TheRARELab/fog-screen-robot-system/README.md

# Anywhere Projected AR for Robot Communication: A Mid-Air Fog Screen-Robot System

This repo has CAD files and code for the following HRI 2025 paper:

> Adrian Lozada, Uthman Tijani, Villa Keth, Hong Wang and Zhao Han.
> "Anywhere Projected AR for Robot Communication: A Mid-Air Fog Screen-Robot System".
> 2025 ACM/IEEE International Conference on Human-Robot Interaction (HRI), 2025.

### Useful links:

- Paper webpage: https://therarelab.com/publications/hri25-anywhere-projected-ar-for-robot-communication-a-mid-air-fog-screen-robot-system/
- Videos are available at https://osf.io/b4efu/.
