TheRARELab/fog-screen-robot-system/fog-machine-control/PCB/README.md

# Fog Machine Controller PCB

This folder holds the PCB design files.

- **BOM_2024-11-13.csv**
  Bill of Materials listing all required components.
- **Gerber_PCB_2024-11-13.zip**
  Gerber manufacturing files for PCB fabrication.
- **PickAndPlace_PCB_2024-11-13.csv**
  Automated assembly coordinates for each component.
