TheRARELab/fog-screen-robot-system/cad_models/iteration_1/README.md

Please see [assembly.md](assembly.md) and [parts.csv](parts.csv).
