TheRARELab/fog-screen-robot-system/fog-machine-control/PCB/PCB-Materials/BOM_2024-11-13.csv

ID | Name | Designator | Footprint | Quantity | Manufacturer Part | Manufacturer | Supplier | Supplier Part | Price | Pins | 3DModel | Contributor | JLCPCB Part Class | link
1 | SS34_C466502 | D1,D2 | SMA_L4.4-W2.6-LS5.0-RD | 2 | SS34 | High Diode(海德) | LCSC | C466502 | 0.056 | 2 | SMA_L4.4-W2.6-LS5.0-RD | LCSC | Extended Part | https://item.szlcsc.com/301402.html
2 | HFD2/005-M-L2 | K1 | RELAY-TH_HFD2-X-X-L2-X | 1 | HFD2/005-M-L2 | HF(宏发) | LCSC | C399485 | 2.147 | 10 | RELAY-TH_HFD2-X-X-L2-X | LCSC | Extended Part | https://item.szlcsc.com/382300.html
3 | WJ500V-5.08-3P-14-00A | P1 | CONN-TH_3P-P5.00_WJ500V-5.08-3P | 1 | WJ500V-5.08-3P | KANGNEX(康奈克斯电气) | LCSC | C72334 | 0.157 | 3 | CONN-TH_3P-P5.00_WJ500V-5.08-3P | 立创EDA官方封装库 | Extended Part | https://item.szlcsc.com/73443.html
4 | 2N4401_C15986 | Q1,Q2 | TO-92-3_L4.9-W3.7-P1.27-L | 2 | 2N4401 | CJ(江苏长电/长晶) | LCSC | C15986 | 0.028 | 3 | TO-92-3_L4.9-W3.7-P1.27-L | lcsc | Extended Part | https://atta.szlcsc.com/upload/public/pdf/source/20180629/C233232_99576441F8ED8E9074FB1575A6BE3592.PDF
5 | 1kΩ | R1,R2 | R0402 | 2 | RC0402FR-071KL | YAGEO(国巨) | LCSC | C106235 | 0.001 | 2 | R0402_L1.0-W0.5-H0.5 | lcsc | Extended Part | https://item.szlcsc.com/323315.html
6 | PM2.54-YP1D-15A | U1,U2 | HDR-TH_15P-P2.54-V-F | 2 | PM2.54-YP1D-15A | XYECONN(辛译) | LCSC | C22399555 | 0.2 | 15 | HDR-TH_15P-P2.54-V-F | lcsc | Extended Part | https://lcsc.com/product-detail/Pin-Header-Female-Header_Made-in-China-Made-in-China-Headers-Pins-1-15P-2-54mm_C54102.html
7 | HLK-PM01 | U3 | PWRM-TH_HLK-PM01 | 1 | HLK-PM01 | HI-LINK(海凌科) | LCSC | C209903 | 2.419 | 4 | PWRM-TH_L34.0-W20.0-H15.0 | LCSC | Extended Part | https://item.szlcsc.com/210981.html
