TheRARELab/fog-screen-robot-system/cad_models/iteration_1/fog_device_model/5mm_housing_lasercut_sheets/housing_sliced_parts_assembly.SLDASM

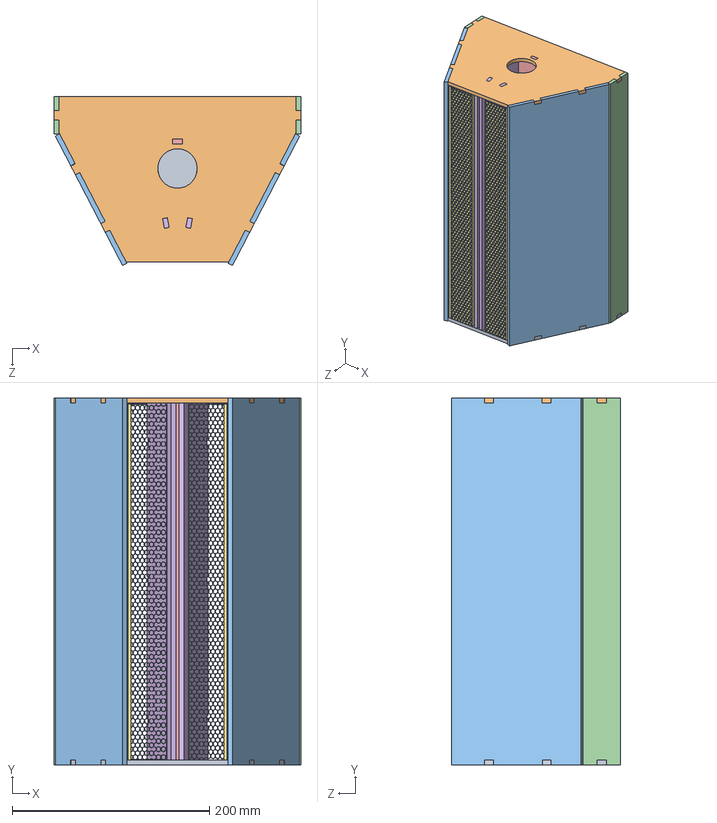
[picture p3: CAD file, 2024-12-19]
cad_models/iteration_1/fog_device_model/5mm_housing_lasercut_sheets/housing_sliced_parts_assembly.SLDASM
250.0 x 372.0 x 171.3 mm
top
top_with_hole
front x 2
fan_side x 2
inner_floor
inner_sheet x 2
5mm_test_airflow_former_iteration1 x 2
