TheRARELab/fog-screen-robot-system/cad_models/iteration_1/fog_screen_brackets/fog_screen_on_shelf_assembly.SLDASM

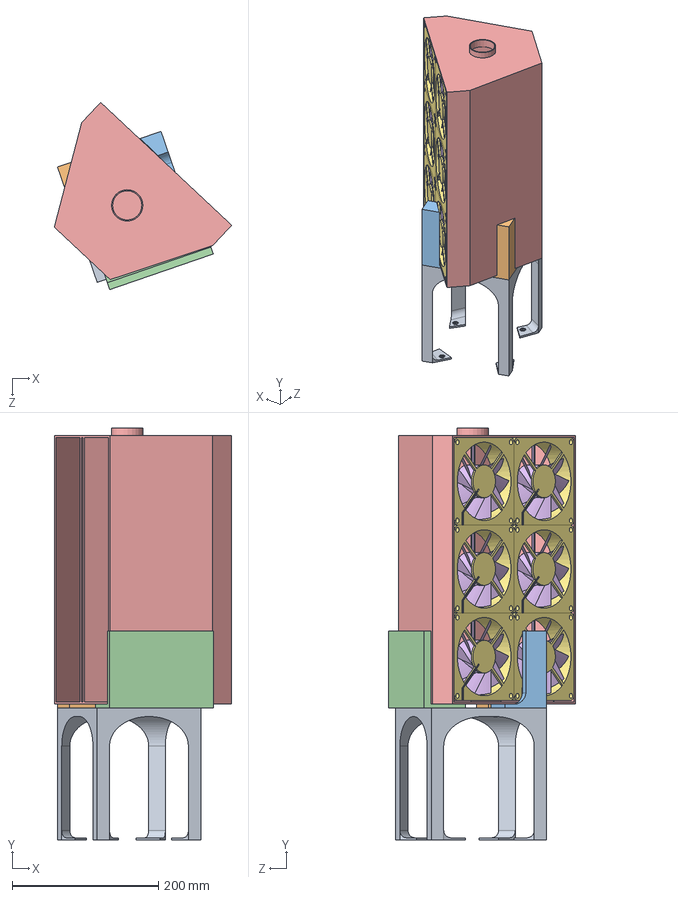
[picture p4: CAD file, 2024-12-19]
cad_models/iteration_1/fog_screen_brackets/fog_screen_on_shelf_assembly.SLDASM
242.9 x 564.0 x 256.3 mm
fog_screen_shelf
fog_screen_on_shelf_bracket_right
fog_screen_on_shelf_bracket_back
fog_screen_on_shelf_bracket_left
housing_iteration1
rotor_120 x 6
stator_120 x 6
