TheRARELab/fog-screen-robot-system/cad_models/first_prototype/3D_printing_models/fogscreen_assembly.SLDASM

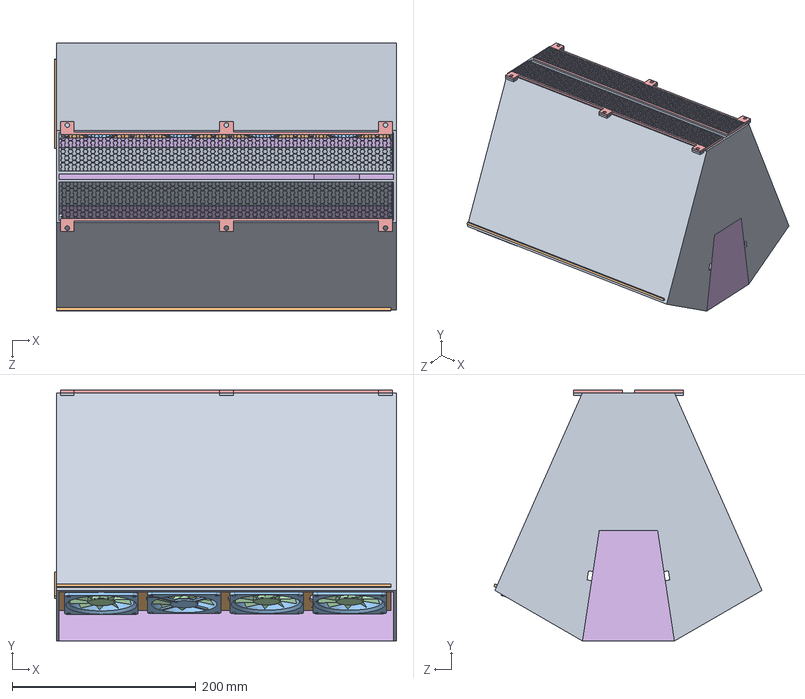
[picture p5: CAD file, 2024-12-19]
cad_models/first_prototype/3D_printing_models/fogscreen_assembly.SLDASM
372.0 x 273.0 x 291.5 mm
baseline_housing
fan_slot x 2
stator x 8
rotor x 8
airflow_former x 2
fog_container
