TheRARELab/fog-screen-robot-system/cad_models/iteration_1/fog_device_model/housing_lasercut_sheets/housing_sliced_parts_assembly.SLDASM

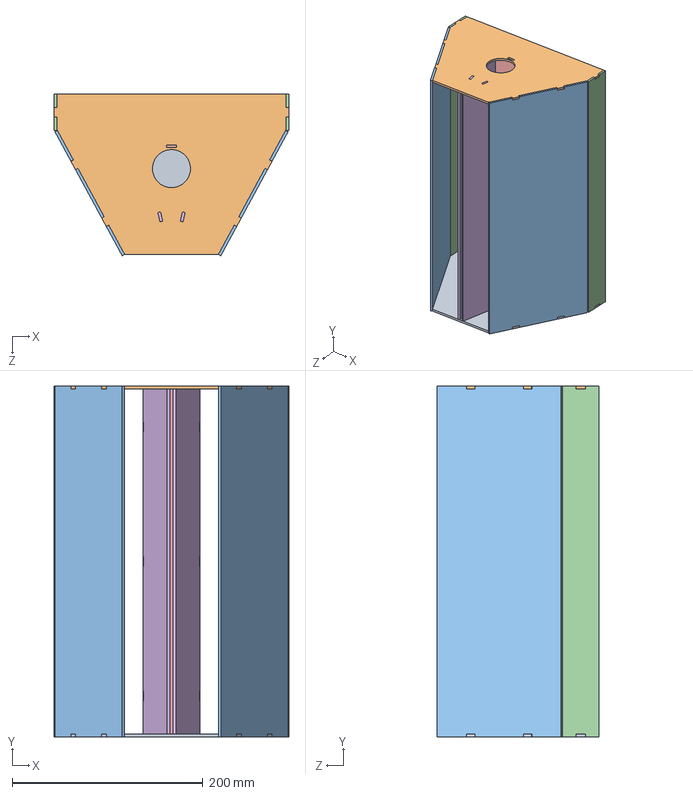
[picture p6: CAD file, 2024-12-19]
cad_models/iteration_1/fog_device_model/housing_lasercut_sheets/housing_sliced_parts_assembly.SLDASM
246.0 x 368.0 x 169.4 mm
top
top_with_hole
front x 2
fan_side x 2
inner_floor
inner_sheet x 2
