TheRARELab/fog-screen-robot-system/cad_models/iteration_1/fog_device_model/iteration1_assembly.SLDASM

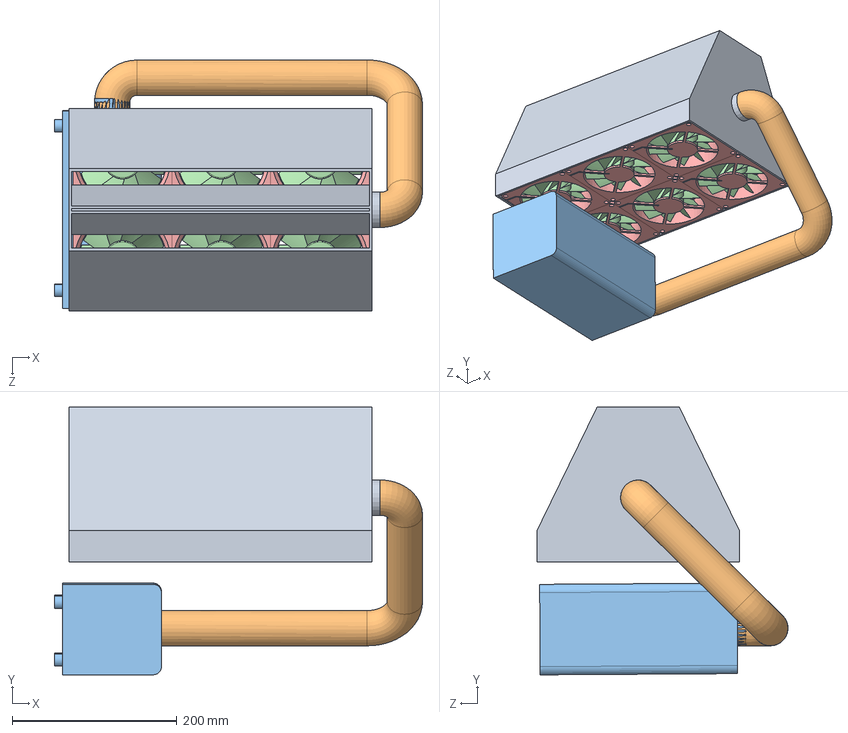
[picture p7: CAD file, 2024-12-19]
cad_models/iteration_1/fog_device_model/iteration1_assembly.SLDASM
447.2 x 325.3 x 305.1 mm
housing_iteration1
pipe
fog_machine
rotor_120 x 6
stator_120 x 6
