TheRARELab/fog-screen-robot-system/cad_models/iteration_1/projector_shelf/projector_shelf_assembly.SLDASM

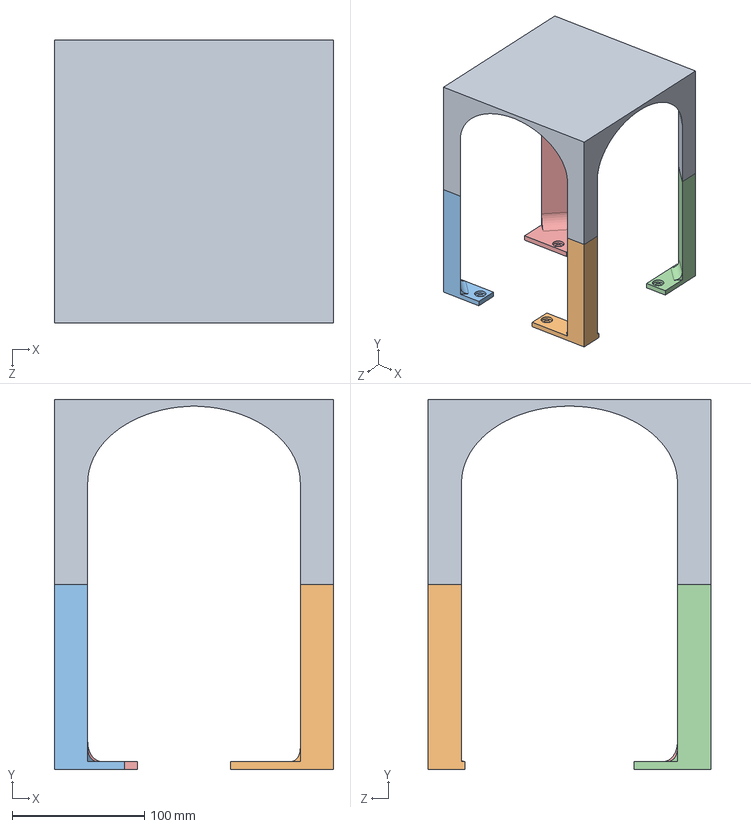
[picture p8: CAD file, 2024-12-19]
cad_models/iteration_1/projector_shelf/projector_shelf_assembly.SLDASM
211.3 x 280.0 x 213.9 mm
projector_shelf_top_with_legs
bottom_leg_1
bottom_leg_2
bottom_leg_3
bottom_leg_4
