TheRARELab/fog-screen-robot-system/cad_models/first_prototype/3D_printing_models/fan.SLDASM

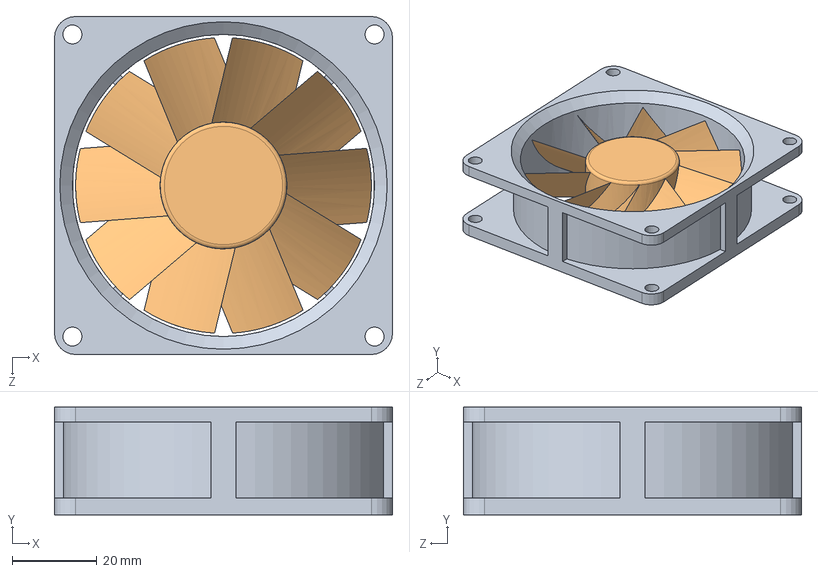
[picture p9: CAD file, 2024-12-19]
cad_models/first_prototype/3D_printing_models/fan.SLDASM
80.0 x 25.5 x 80.0 mm
stator
rotor
