TheRARELab/fog-screen-robot-system/cad_models/iteration_1/fog_device_model/fan_120.SLDASM

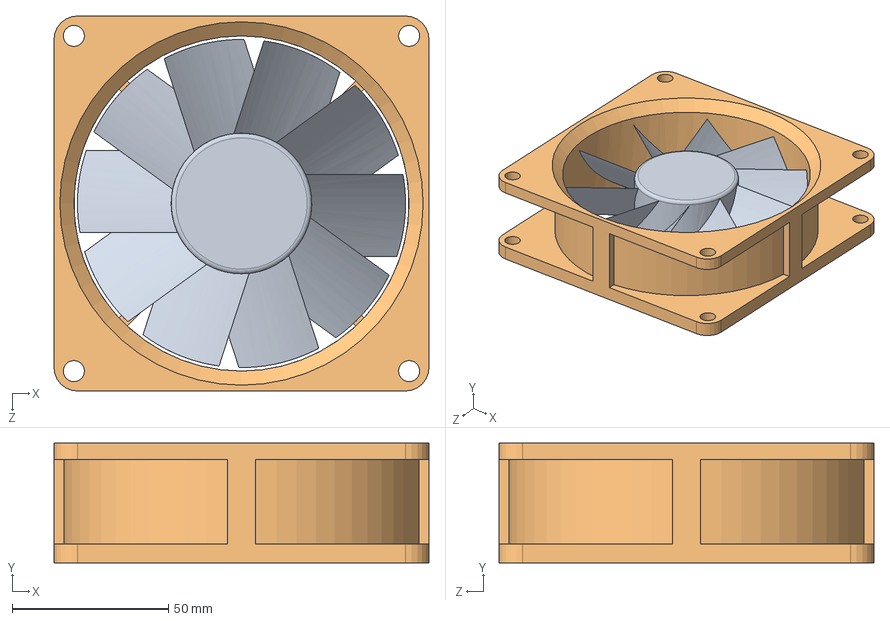
[picture p10: CAD file, 2024-12-19]
cad_models/iteration_1/fog_device_model/fan_120.SLDASM
120.0 x 38.2 x 120.0 mm
rotor_120
stator_120
