TheRARELab/fog-screen-robot-system/cad_models/first_prototype/3D_printing_models/fog_container.SLDPRT

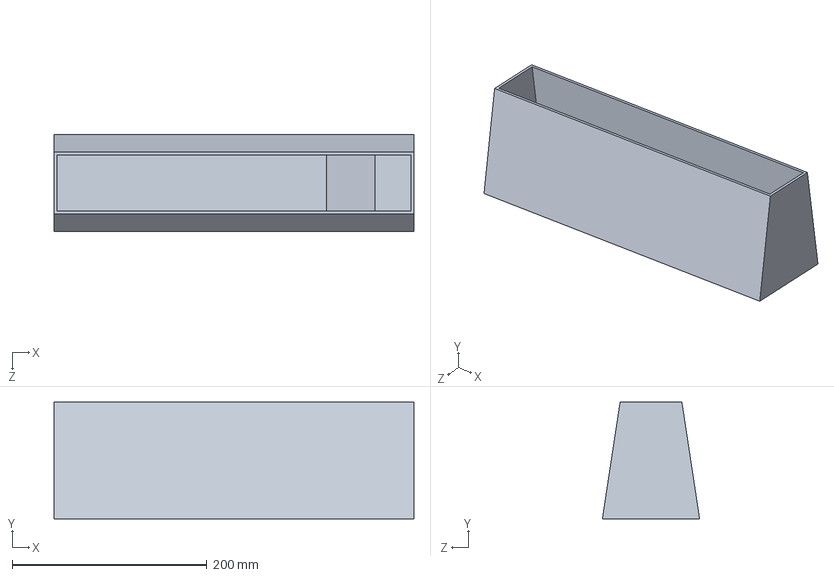
[picture p11: CAD file, 2024-12-19]
cad_models/first_prototype/3D_printing_models/fog_container.SLDPRT
370.0 x 120.0 x 100.0 mm
