TheRARELab/fog-screen-robot-system/cad_models/first_prototype/3D_printing_models/improvement_testing/half_airflow_former1.STL

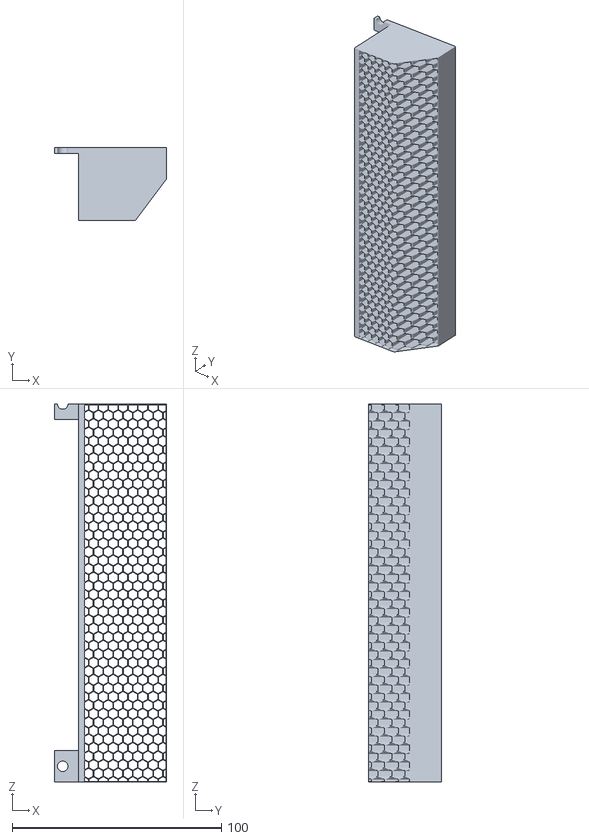
[picture p12: CAD file, 2024-12-19]
cad_models/first_prototype/3D_printing_models/improvement_testing/half_airflow_former1.STL
53.6 x 35.0 x 180.5
