TheRARELab/fog-screen-robot-system/cad_models/first_prototype/laser_cutting_models/fan_slot.SLDPRT

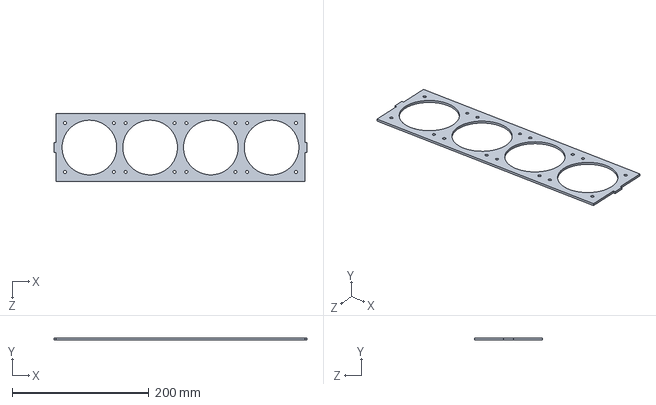
[picture p13: CAD file, 2024-12-19]
cad_models/first_prototype/laser_cutting_models/fan_slot.SLDPRT
370.0 x 3.00 x 100.0 mm
