TheRARELab/fog-screen-robot-system/cad_models/iteration_1/fog_device_model/5mm_housing_lasercut_sheets/5mm_test_airflow_former_iteration1.STL

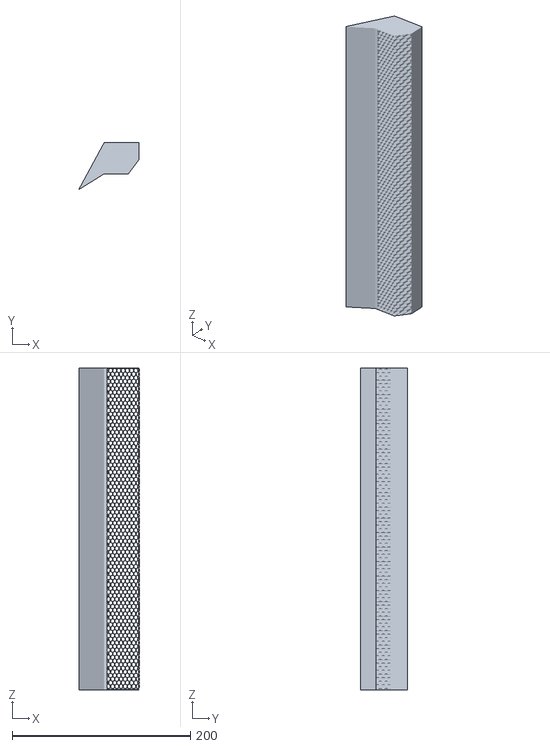
[picture p15: CAD file, 2024-12-19]
cad_models/iteration_1/fog_device_model/5mm_housing_lasercut_sheets/5mm_test_airflow_former_iteration1.STL
67.3 x 52.3 x 361.1
