TheRARELab/fog-screen-robot-system/cad_models/iteration_1/fog_device_model/housing_iteration1.SLDPRT

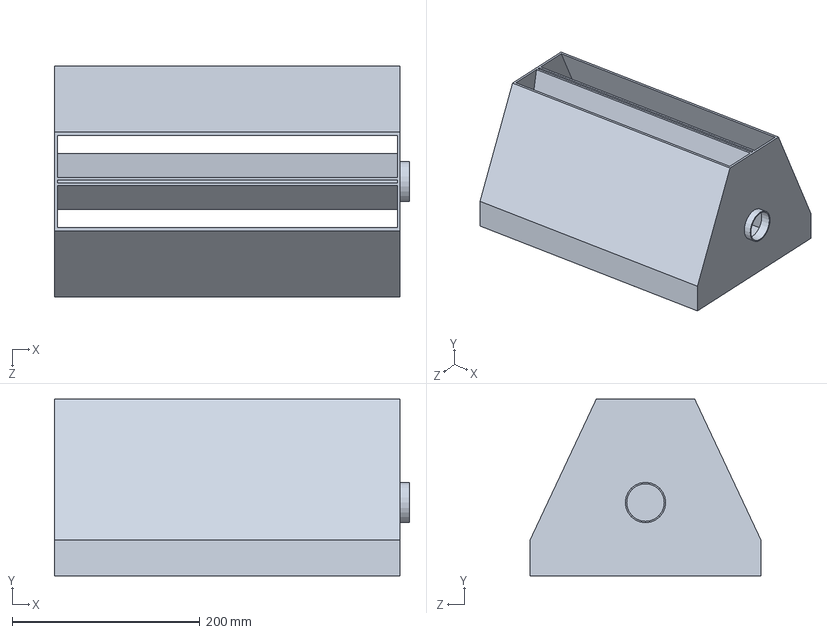
[picture p16: CAD file, 2024-12-19]
cad_models/iteration_1/fog_device_model/housing_iteration1.SLDPRT
378.0 x 188.0 x 246.0 mm
