TheRARELab/fog-screen-robot-system/cad_models/iteration_1/fog_device_model/housing_lasercut_sheets/fan_side.SLDPRT

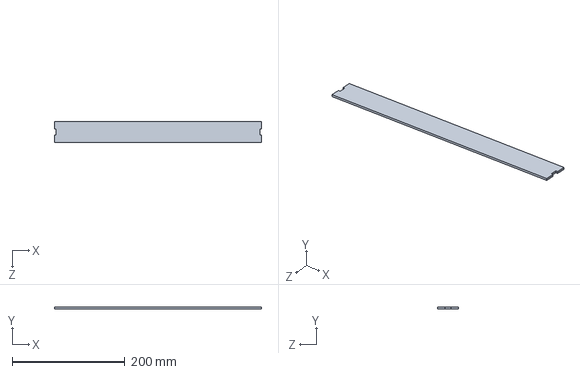
[picture p17: CAD file, 2024-12-19]
cad_models/iteration_1/fog_device_model/housing_lasercut_sheets/fan_side.SLDPRT
368.0 x 3.00 x 38.0 mm
