TheRARELab/fog-screen-robot-system/cad_models/iteration_1/fog_device_model/mount_structures/projector_raise.SLDPRT

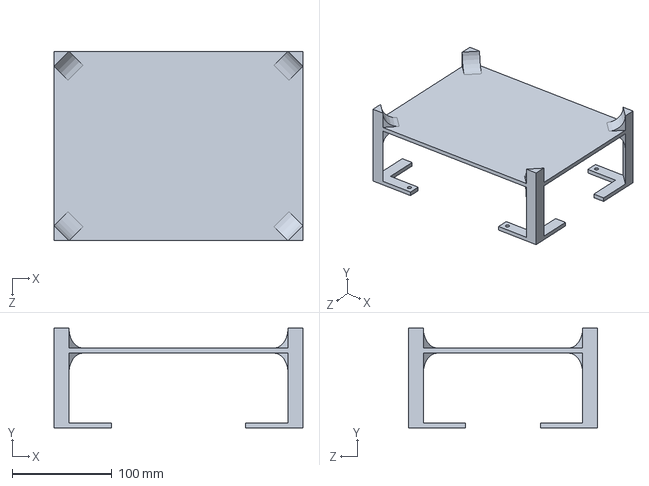
[picture p18: CAD file, 2024-12-19]
cad_models/iteration_1/fog_device_model/mount_structures/projector_raise.SLDPRT
250.0 x 100.0 x 190.0 mm
