TheRARELab/fog-screen-robot-system/cad_models/iteration_1/fog_machine_brackets/fog_machine_right_bracket.SLDPRT

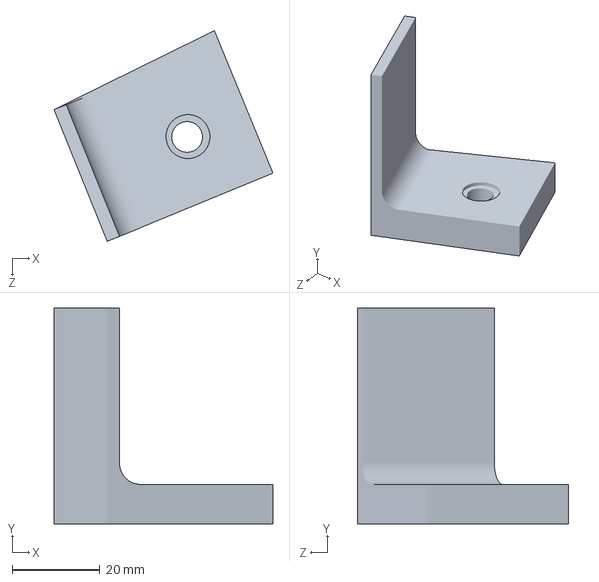
[picture p19: CAD file, 2024-12-19]
cad_models/iteration_1/fog_machine_brackets/fog_machine_right_bracket.SLDPRT
49.8 x 49.1 x 47.9 mm
