TheRARELab/fog-screen-robot-system/cad_models/iteration_1/fog_screen_brackets/fog_screen_on_shelf_bracket_left.SLDPRT

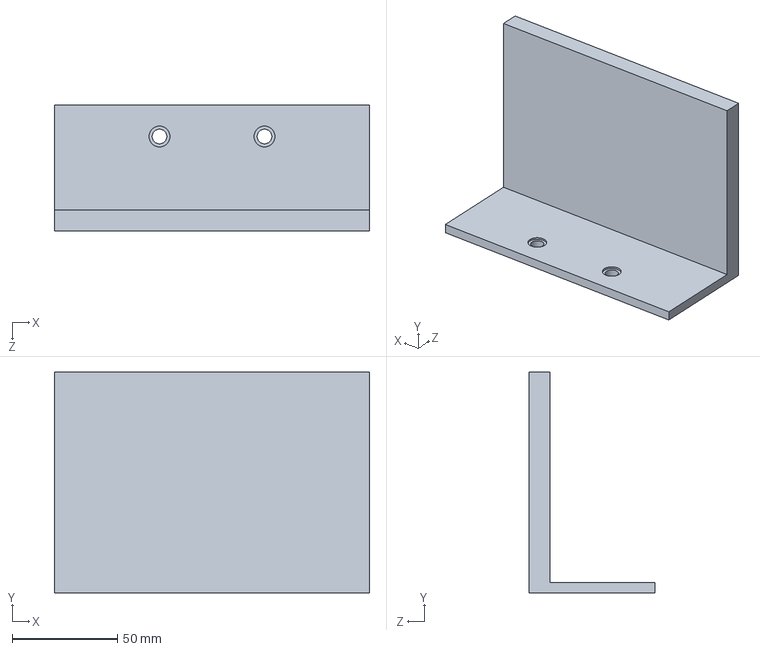
[picture p20: CAD file, 2024-12-19]
cad_models/iteration_1/fog_screen_brackets/fog_screen_on_shelf_bracket_left.SLDPRT
150.0 x 105.0 x 60.0 mm
