TheRARELab/fog-screen-robot-system/cad_models/iteration_1/fog_screen_shelf/fog_screen_shelf.SLDPRT

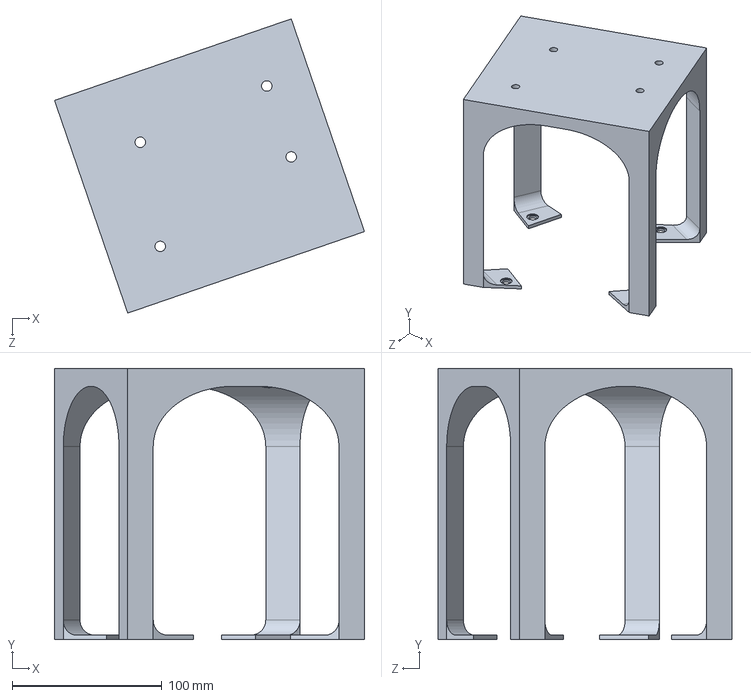
[picture p21: CAD file, 2024-12-19]
cad_models/iteration_1/fog_screen_shelf/fog_screen_shelf.SLDPRT
206.7 x 181.0 x 196.2 mm
