TheRARELab/fog-screen-robot-system/cad_models/iteration_1/projector_shelf/bottom_leg_1.SLDPRT

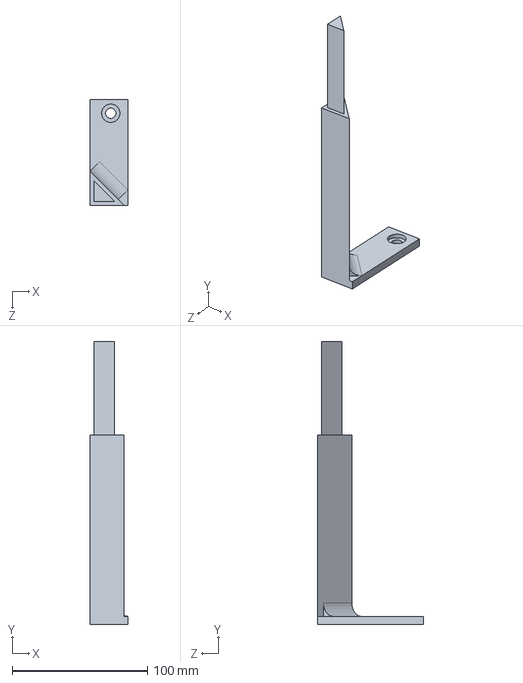
[picture p22: CAD file, 2024-12-19]
cad_models/iteration_1/projector_shelf/bottom_leg_1.SLDPRT
28.0 x 209.0 x 78.1 mm
