TheRARELab/fog-screen-robot-system/fog-machine-control/case/FogScreenControllerCase/Klein_FogScreenControllerCaseUpdate.SLDPRT

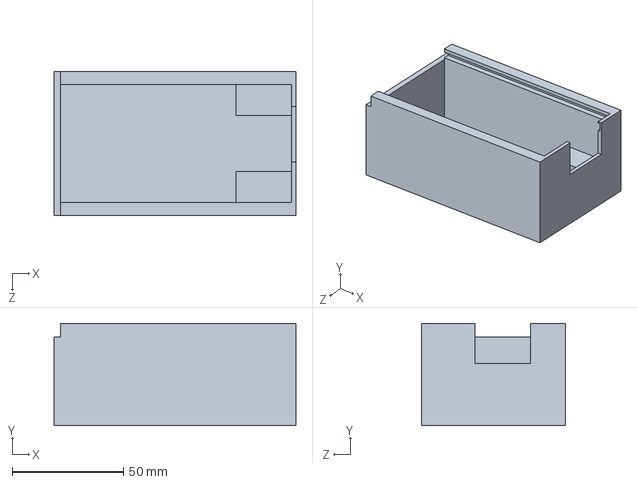
[picture p23: CAD file, 2025-02-14]
fog-machine-control/case/FogScreenControllerCase/Klein_FogScreenControllerCaseUpdate.SLDPRT
109.0 x 46.0 x 65.0 mm
