TheRARELab/fog-screen-robot-system/cad_models/first_prototype/3D_printing_models/fan_slot.SLDPRT

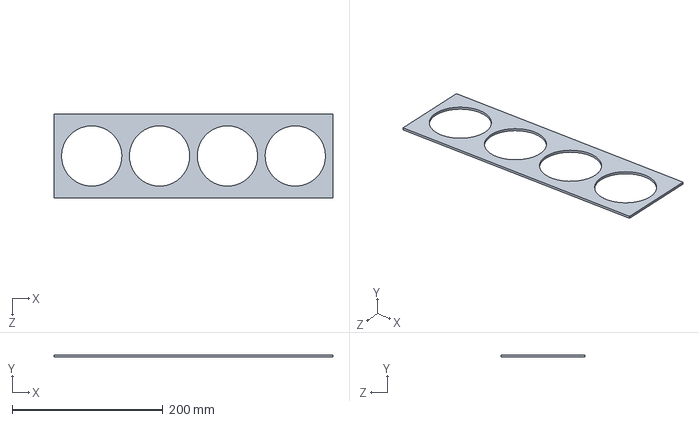
[picture p24: CAD file, 2024-12-19]
cad_models/first_prototype/3D_printing_models/fan_slot.SLDPRT
370.0 x 3.00 x 111.8 mm
