TheRARELab/fog-screen-robot-system/cad_models/first_prototype/3D_printing_models/improvement_testing/fog_outlet_reduce.SLDPRT

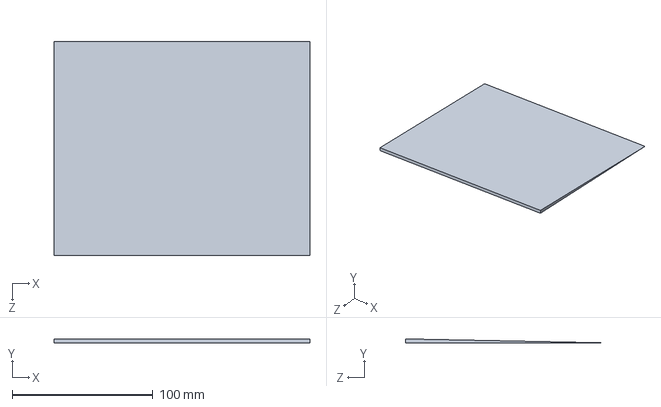
[picture p25: CAD file, 2024-12-19]
cad_models/first_prototype/3D_printing_models/improvement_testing/fog_outlet_reduce.SLDPRT
182.0 x 3.00 x 151.9 mm
