TheRARELab/fog-screen-robot-system/cad_models/first_prototype/laser_cutting_models/side_cut_housing.SLDPRT

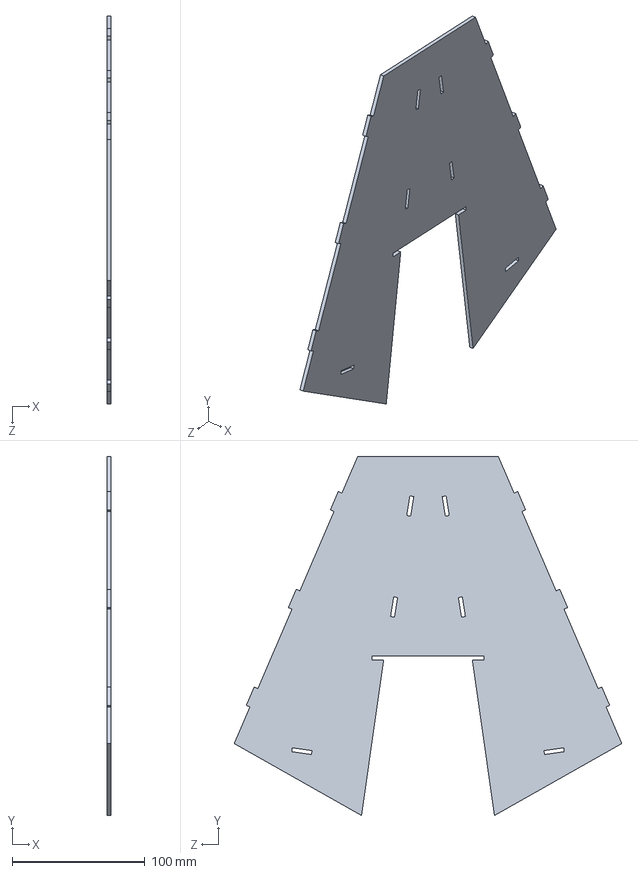
[picture p26: CAD file, 2024-12-19]
cad_models/first_prototype/laser_cutting_models/side_cut_housing.SLDPRT
3.00 x 270.0 x 291.5 mm
