TheRARELab/fog-screen-robot-system/cad_models/iteration_1/fog_device_model/5mm_housing_lasercut_sheets/fan_side.SLDPRT

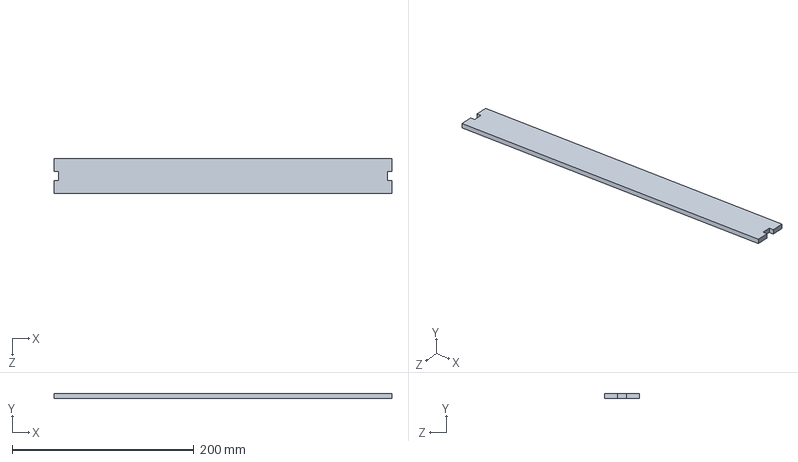
[picture p27: CAD file, 2024-12-19]
cad_models/iteration_1/fog_device_model/5mm_housing_lasercut_sheets/fan_side.SLDPRT
372.0 x 5.00 x 38.0 mm
