TheRARELab/fog-screen-robot-system/cad_models/iteration_1/fog_device_model/housing_lasercut_sheets/front.SLDPRT

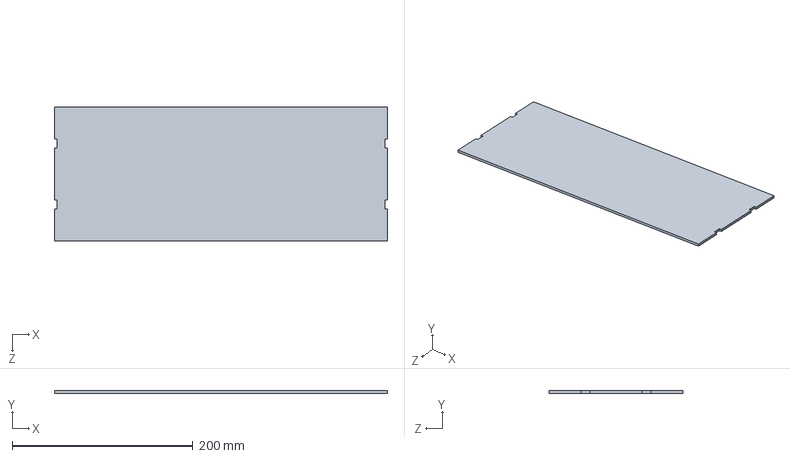
[picture p28: CAD file, 2024-12-19]
cad_models/iteration_1/fog_device_model/housing_lasercut_sheets/front.SLDPRT
368.0 x 3.00 x 147.9 mm
