TheRARELab/fog-screen-robot-system/cad_models/iteration_1/fog_device_model/rotor_120.SLDPRT

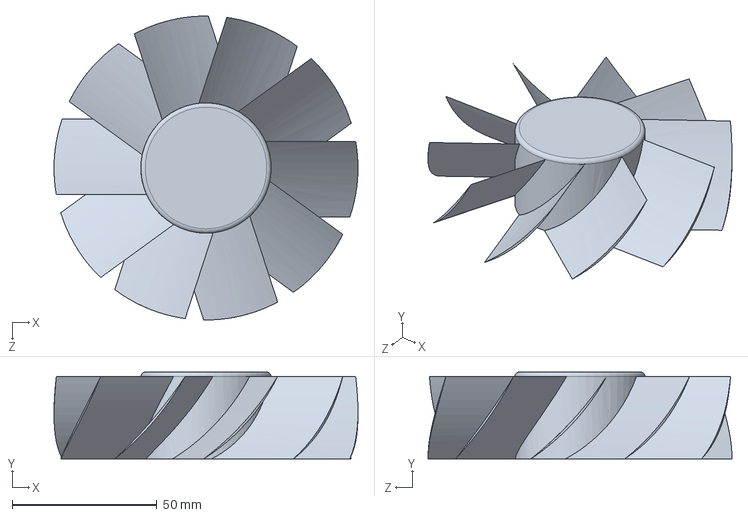
[picture p29: CAD file, 2024-12-19]
cad_models/iteration_1/fog_device_model/rotor_120.SLDPRT
105.0 x 30.0 x 105.0 mm
