TheRARELab/fog-screen-robot-system/cad_models/iteration_1/fog_machine_brackets/fog_machine_back_bracket.SLDPRT

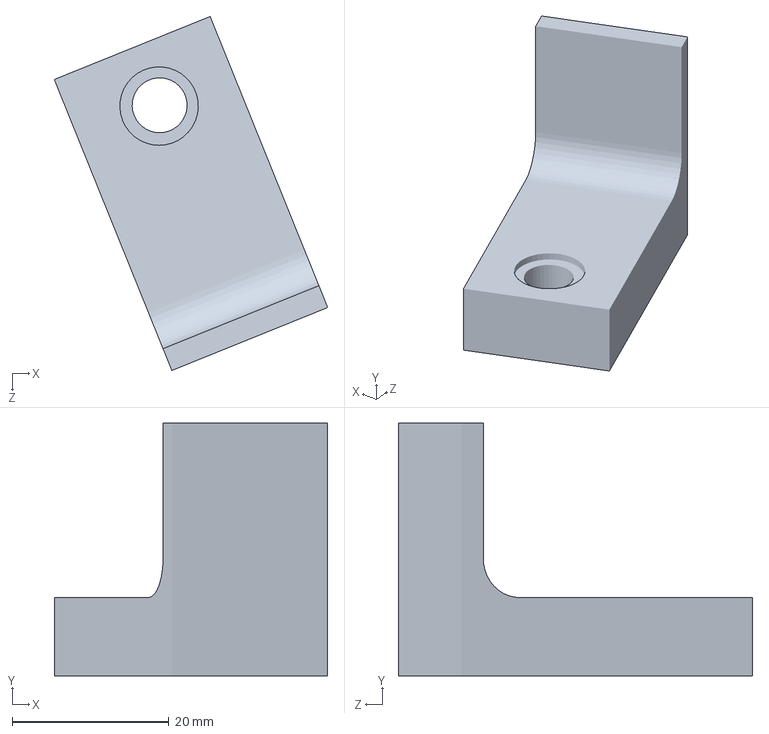
[picture p30: CAD file, 2024-12-19]
cad_models/iteration_1/fog_machine_brackets/fog_machine_back_bracket.SLDPRT
34.9 x 32.2 x 45.1 mm
