TheRARELab/fog-screen-robot-system/cad_models/iteration_1/fog_screen_brackets/fog_screen_on_shelf_bracket_right.SLDPRT

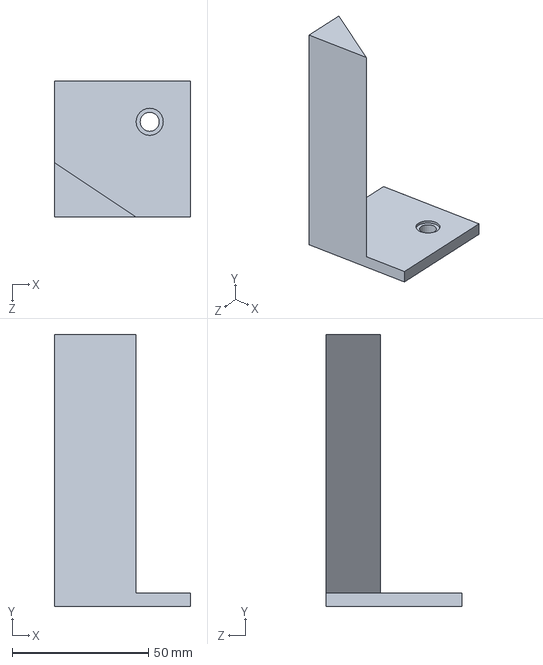
[picture p31: CAD file, 2024-12-19]
cad_models/iteration_1/fog_screen_brackets/fog_screen_on_shelf_bracket_right.SLDPRT
50.0 x 100.0 x 50.0 mm
