TheRARELab/fog-screen-robot-system/cad_models/iteration_1/projector_shelf/bottom_leg_2.SLDPRT

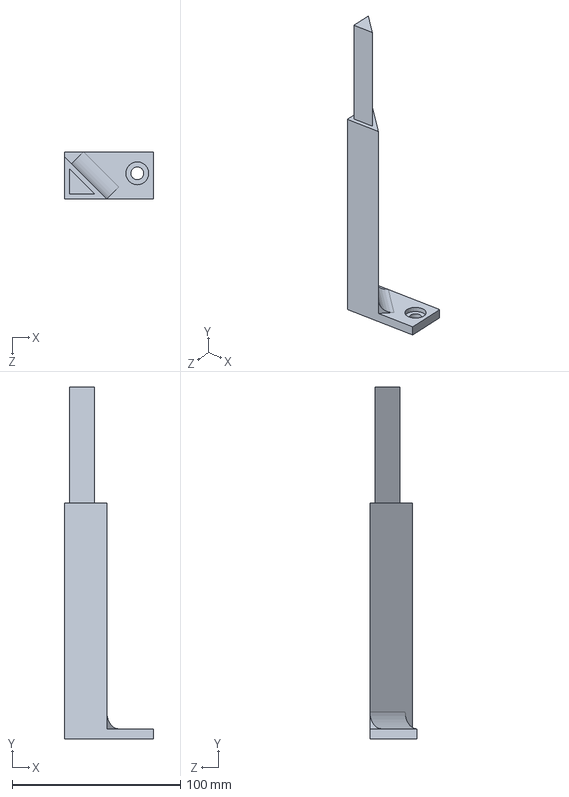
[picture p32: CAD file, 2024-12-19]
cad_models/iteration_1/projector_shelf/bottom_leg_2.SLDPRT
53.0 x 209.0 x 28.0 mm
