TheRARELab/fog-screen-robot-system/fog-machine-control/case/FogScreenControllerCase/Klein_FogScreenControllerCaseLidUpdate.SLDPRT

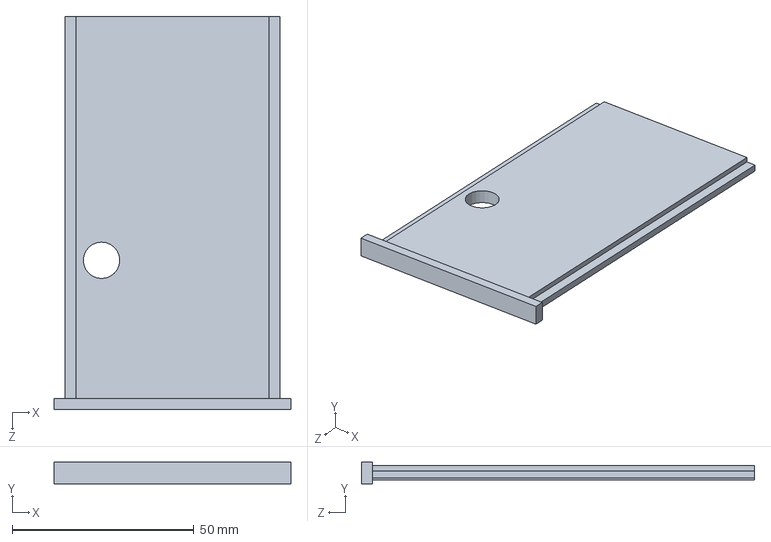
[picture p33: CAD file, 2025-02-14]
fog-machine-control/case/FogScreenControllerCase/Klein_FogScreenControllerCaseLidUpdate.SLDPRT
65.0 x 6.00 x 108.0 mm
