TheRARELab/fog-screen-robot-system/cad_models/first_prototype/3D_printing_models/stator.SLDPRT

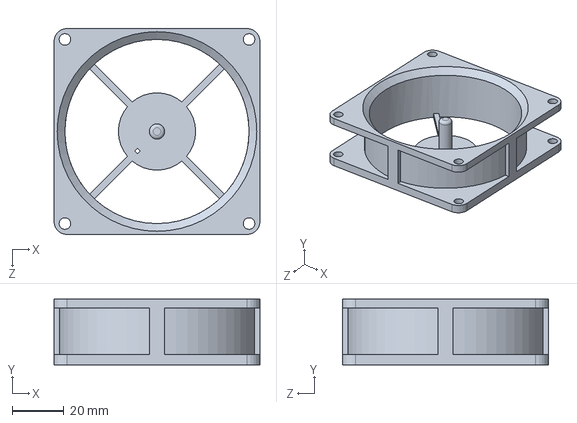
[picture p34: CAD file, 2024-12-19]
cad_models/first_prototype/3D_printing_models/stator.SLDPRT
80.0 x 25.5 x 80.0 mm
