TheRARELab/fog-screen-robot-system/cad_models/first_prototype/laser_cutting_models/floor_container.SLDPRT

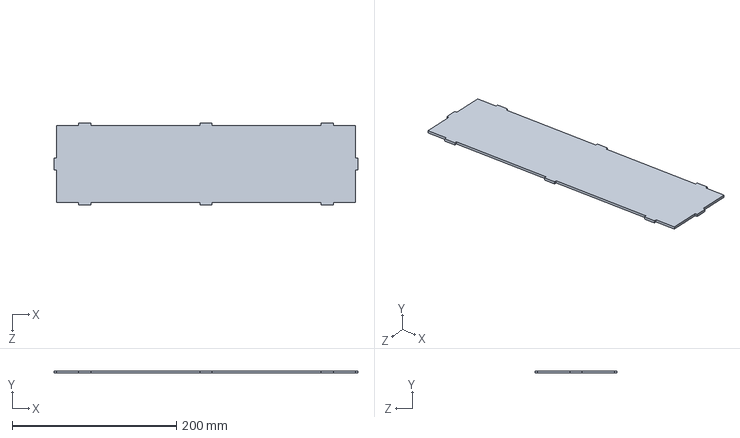
[picture p35: CAD file, 2024-12-19]
cad_models/first_prototype/laser_cutting_models/floor_container.SLDPRT
370.0 x 3.00 x 100.0 mm
