TheRARELab/fog-screen-robot-system/cad_models/iteration_1/fog_device_model/5mm_housing_lasercut_sheets/top_with_hole.SLDPRT

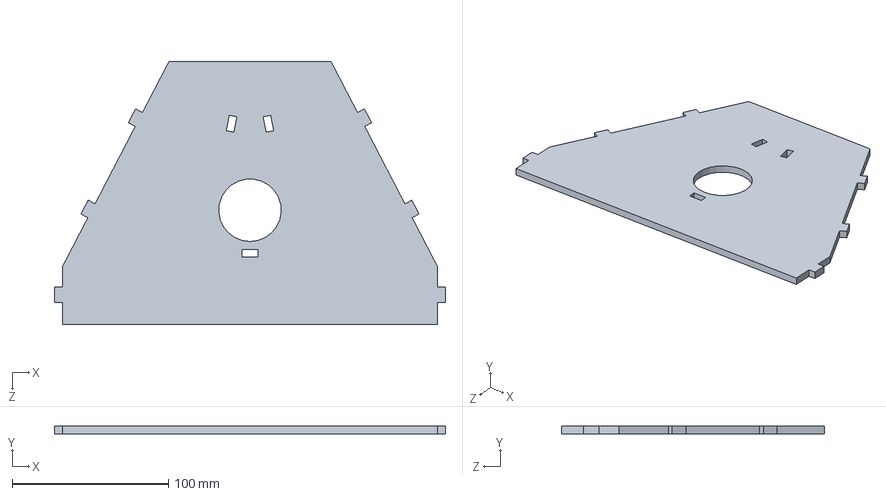
[picture p36: CAD file, 2024-12-19]
cad_models/iteration_1/fog_device_model/5mm_housing_lasercut_sheets/top_with_hole.SLDPRT
250.0 x 5.00 x 168.0 mm
