TheRARELab/fog-screen-robot-system/cad_models/iteration_1/fog_device_model/housing_lasercut_sheets/inner_sheet.SLDPRT

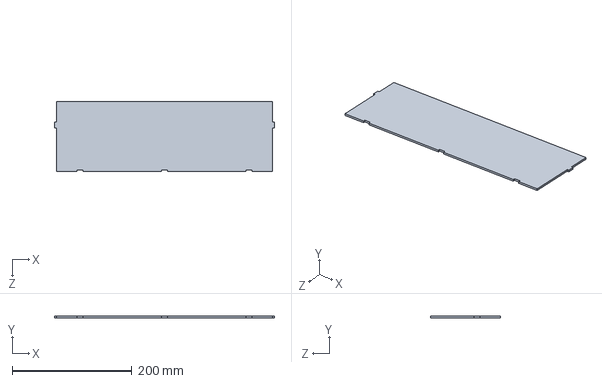
[picture p37: CAD file, 2024-12-19]
cad_models/iteration_1/fog_device_model/housing_lasercut_sheets/inner_sheet.SLDPRT
368.0 x 3.00 x 117.8 mm
