TheRARELab/fog-screen-robot-system/cad_models/iteration_1/fog_device_model/stator_120.SLDPRT

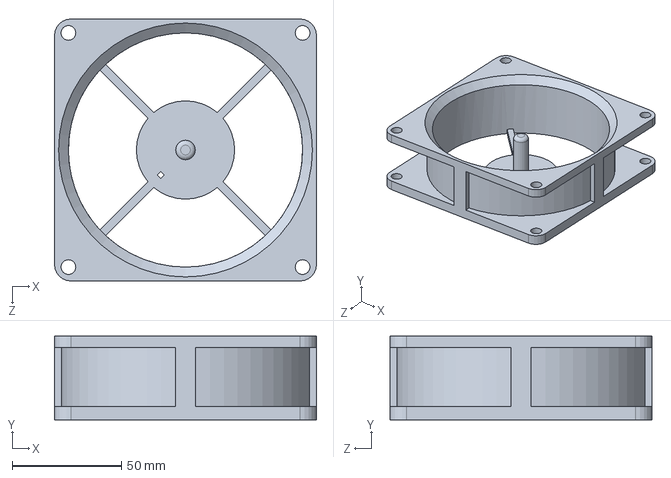
[picture p38: CAD file, 2024-12-19]
cad_models/iteration_1/fog_device_model/stator_120.SLDPRT
120.0 x 38.2 x 120.0 mm
