TheRARELab/fog-screen-robot-system/cad_models/iteration_1/fog_machine_brackets/fog_machine_front_bracket.SLDPRT

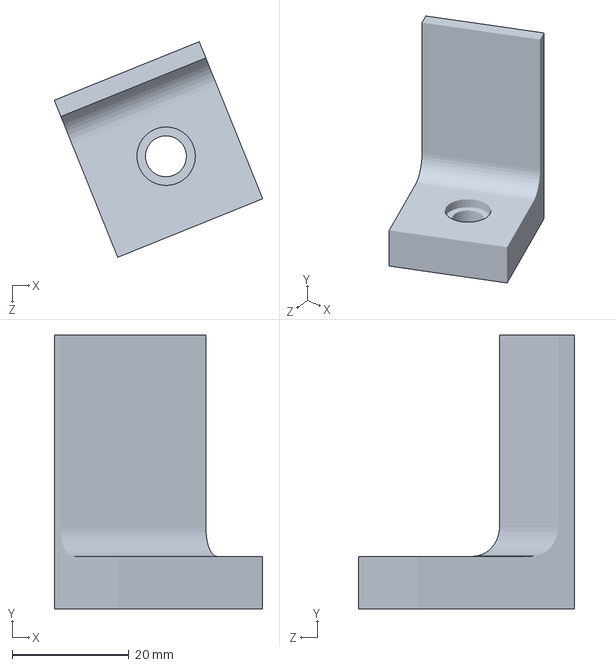
[picture p39: CAD file, 2024-12-19]
cad_models/iteration_1/fog_machine_brackets/fog_machine_front_bracket.SLDPRT
35.6 x 46.8 x 36.9 mm
