TheRARELab/fog-screen-robot-system/cad_models/iteration_1/fog_screen_brackets/fog_screen_on_shelf_bracket_back.SLDPRT

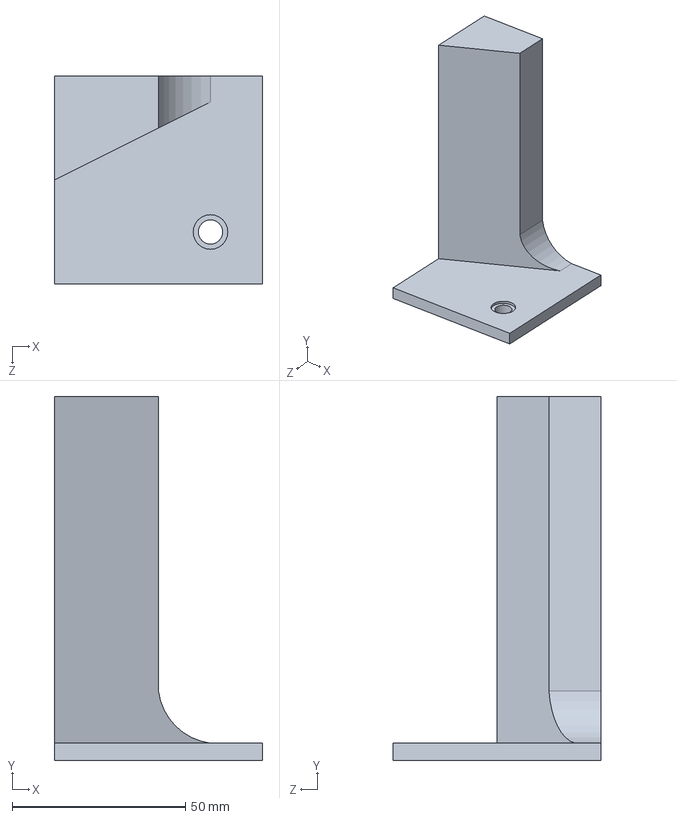
[picture p40: CAD file, 2024-12-19]
cad_models/iteration_1/fog_screen_brackets/fog_screen_on_shelf_bracket_back.SLDPRT
60.0 x 105.0 x 60.0 mm
