TheRARELab/fog-screen-robot-system/cad_models/iteration_1/projector_shelf/bottom_leg_3.SLDPRT

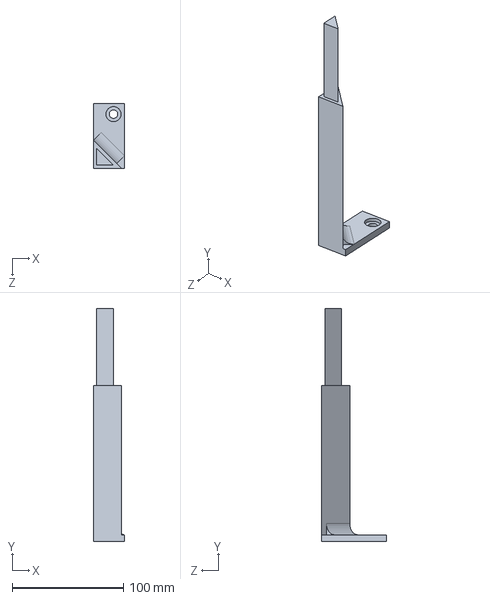
[picture p41: CAD file, 2024-12-19]
cad_models/iteration_1/projector_shelf/bottom_leg_3.SLDPRT
28.0 x 209.0 x 58.0 mm
