TheRARELab/fog-screen-robot-system/cad_models/first_prototype/3D_printing_models/baseline_housing.SLDPRT

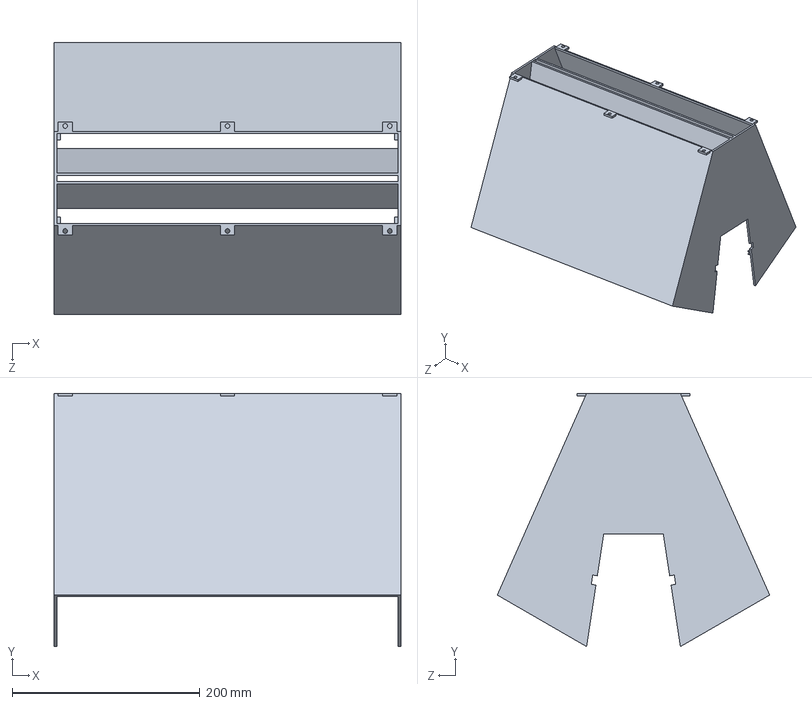
[picture p42: CAD file, 2024-12-19]
cad_models/first_prototype/3D_printing_models/baseline_housing.SLDPRT
370.0 x 270.0 x 290.5 mm
