TheRARELab/fog-screen-robot-system/cad_models/iteration_1/fog_device_model/housing_lasercut_sheets/inner_floor.SLDPRT

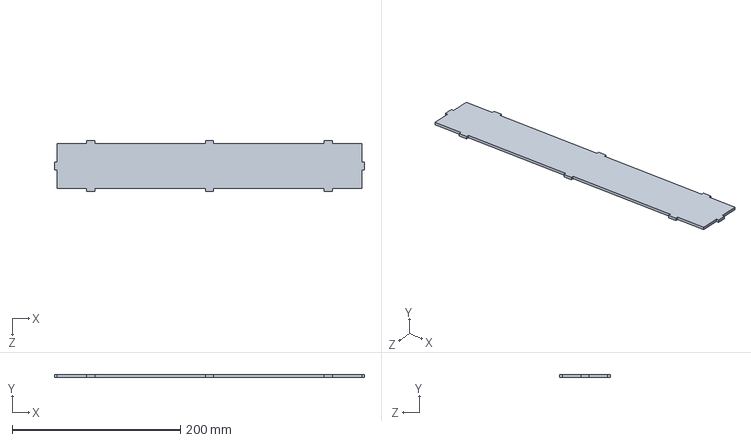
[picture p43: CAD file, 2024-12-19]
cad_models/iteration_1/fog_device_model/housing_lasercut_sheets/inner_floor.SLDPRT
368.0 x 3.00 x 60.0 mm
