TheRARELab/fog-screen-robot-system/cad_models/iteration_1/fog_device_model/pipe.SLDPRT

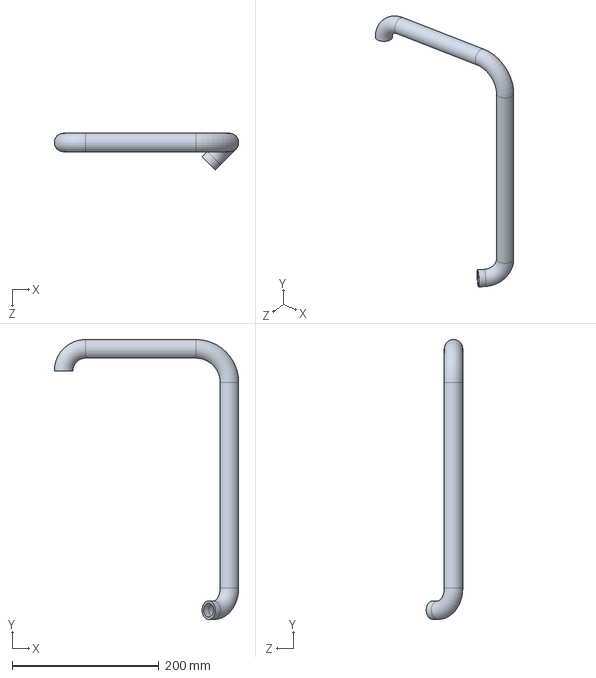
[picture p44: CAD file, 2024-12-19]
cad_models/iteration_1/fog_device_model/pipe.SLDPRT
251.1 x 381.1 x 50.0 mm
