TheRARELab/fog-screen-robot-system/cad_models/iteration_1/fog_machine_brackets/fog_machine_left_bracket.SLDPRT

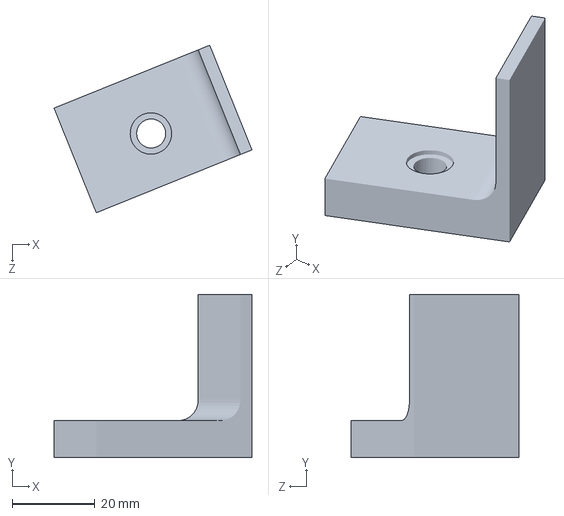
[picture p45: CAD file, 2024-12-19]
cad_models/iteration_1/fog_machine_brackets/fog_machine_left_bracket.SLDPRT
47.8 x 39.5 x 40.4 mm
