TheRARELab/fog-screen-robot-system/cad_models/iteration_1/projector_shelf/bottom_leg_4.SLDPRT

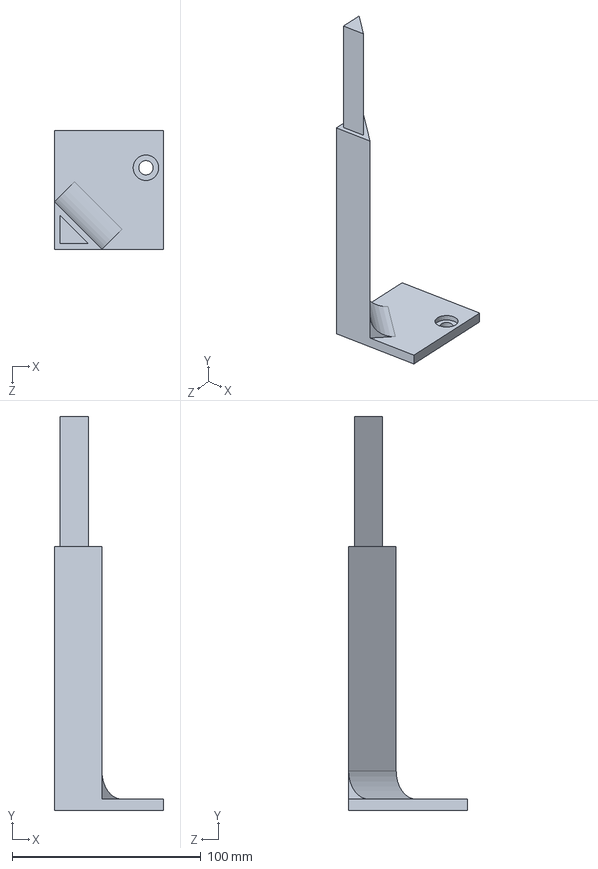
[picture p46: CAD file, 2024-12-19]
cad_models/iteration_1/projector_shelf/bottom_leg_4.SLDPRT
58.0 x 209.0 x 63.0 mm
