TheRARELab/fog-screen-robot-system/cad_models/first_prototype/laser_cutting_models/side_container.SLDPRT

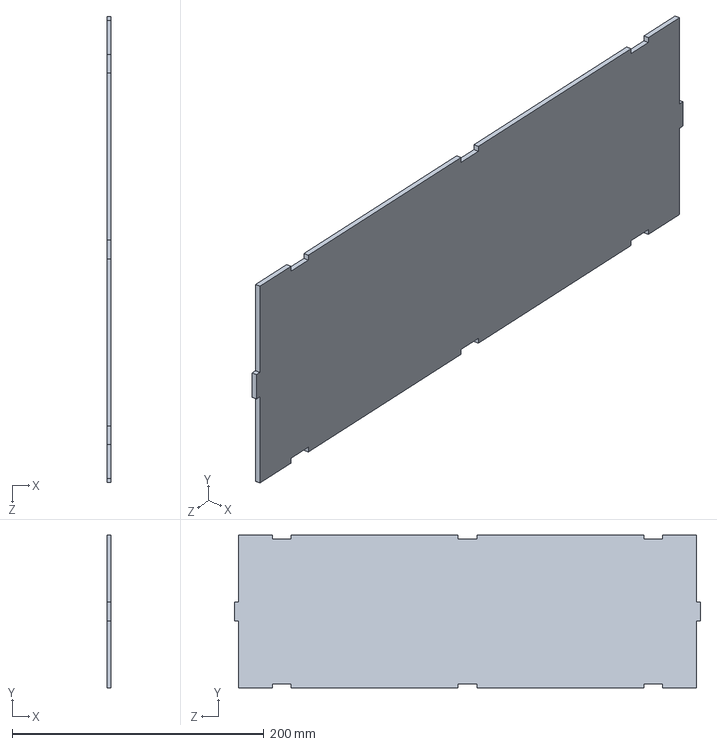
[picture p47: CAD file, 2024-12-19]
cad_models/first_prototype/laser_cutting_models/side_container.SLDPRT
3.00 x 121.4 x 370.0 mm
