TheRARELab/fog-screen-robot-system/cad_models/iteration_1/fog_device_model/5mm_housing_lasercut_sheets/inner_floor.SLDPRT

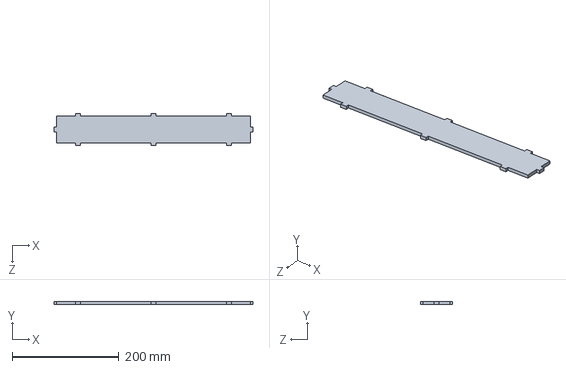
[picture p48: CAD file, 2024-12-19]
cad_models/iteration_1/fog_device_model/5mm_housing_lasercut_sheets/inner_floor.SLDPRT
372.0 x 5.00 x 60.0 mm
