TheRARELab/fog-screen-robot-system/cad_models/first_prototype/laser_cutting_models/front_cut_housing.SLDPRT

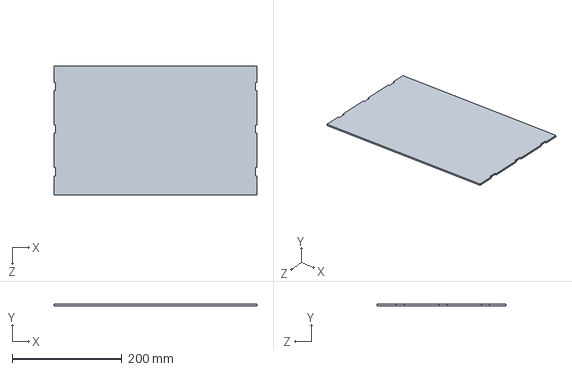
[picture p49: CAD file, 2024-12-19]
cad_models/first_prototype/laser_cutting_models/front_cut_housing.SLDPRT
370.0 x 3.00 x 235.0 mm
