TheRARELab/fog-screen-robot-system/cad_models/iteration_1/projector_shelf/projector_shelf_top_with_legs.SLDPRT

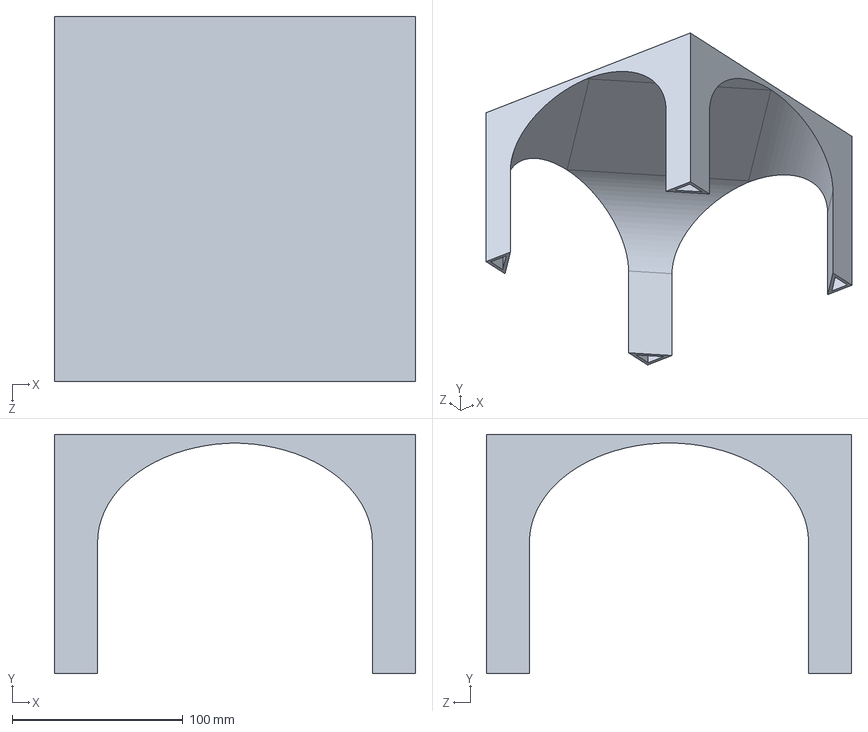
[picture p52: CAD file, 2024-12-19]
cad_models/iteration_1/projector_shelf/projector_shelf_top_with_legs.SLDPRT
211.3 x 140.0 x 213.9 mm
