TheRARELab/fog-screen-robot-system/cad_models/first_prototype/3D_printing_models/rotor.SLDPRT

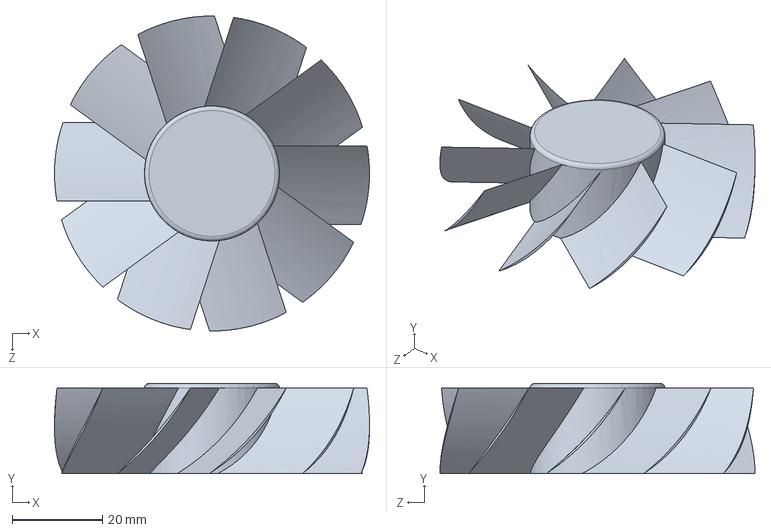
[picture p53: CAD file, 2024-12-19]
cad_models/first_prototype/3D_printing_models/rotor.SLDPRT
70.0 x 20.0 x 70.0 mm
