TheRARELab/fog-screen-robot-system/cad_models/first_prototype/laser_cutting_models/front_container.SLDPRT

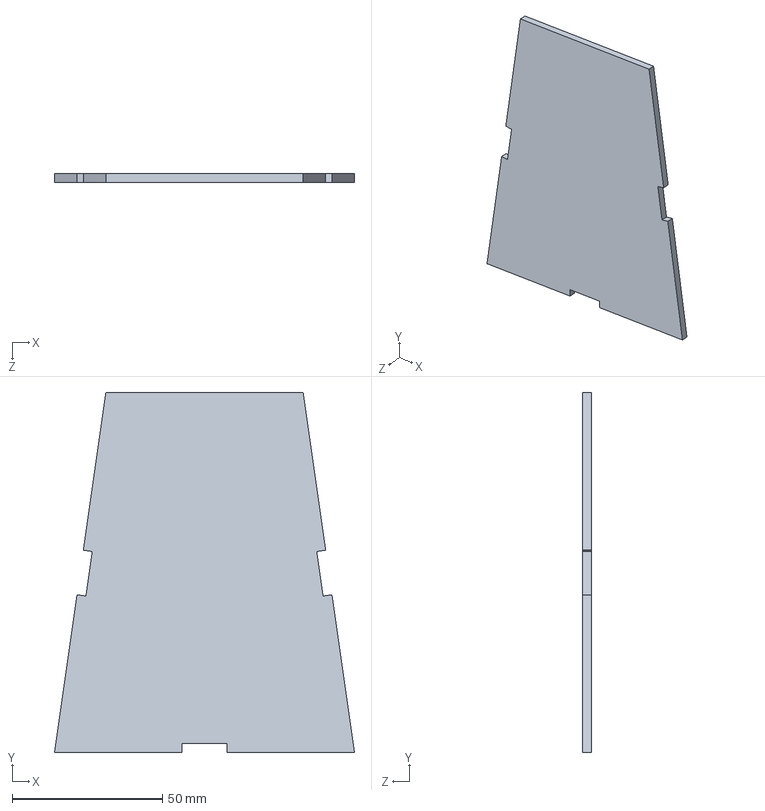
[picture p54: CAD file, 2024-12-19]
cad_models/first_prototype/laser_cutting_models/front_container.SLDPRT
100.0 x 120.0 x 3.00 mm
