TheRARELab/fog-screen-robot-system/cad_models/iteration_1/fog_device_model/5mm_housing_lasercut_sheets/inner_sheet.SLDPRT

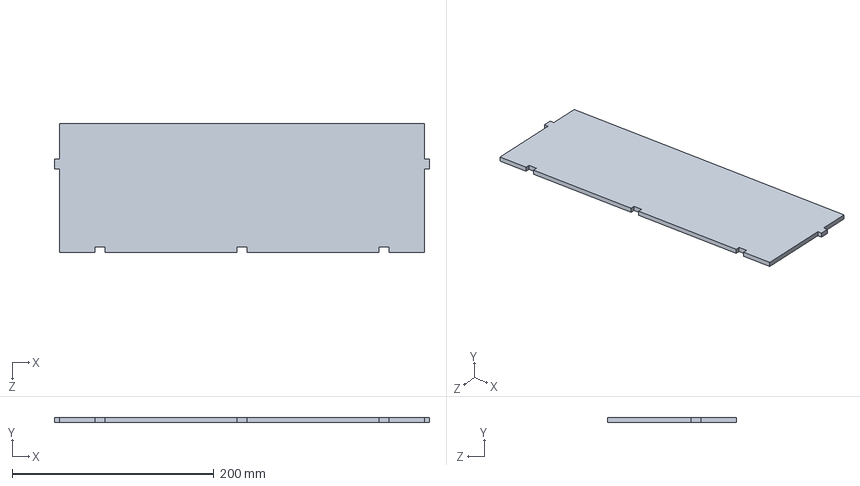
[picture p55: CAD file, 2024-12-19]
cad_models/iteration_1/fog_device_model/5mm_housing_lasercut_sheets/inner_sheet.SLDPRT
372.0 x 5.00 x 127.5 mm
