TheRARELab/fog-screen-robot-system/cad_models/iteration_1/fog_device_model/airflow_former_iteration1.STL

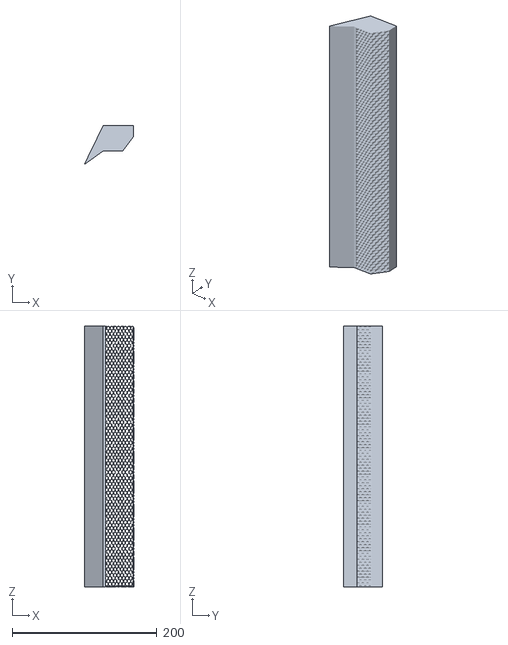
[picture p56: CAD file, 2024-12-19]
cad_models/iteration_1/fog_device_model/airflow_former_iteration1.STL
68.0 x 53.4 x 361.1
