TheRARELab/fog-screen-robot-system/cad_models/iteration_1/fog_device_model/housing_lasercut_sheets/top_with_hole.SLDPRT

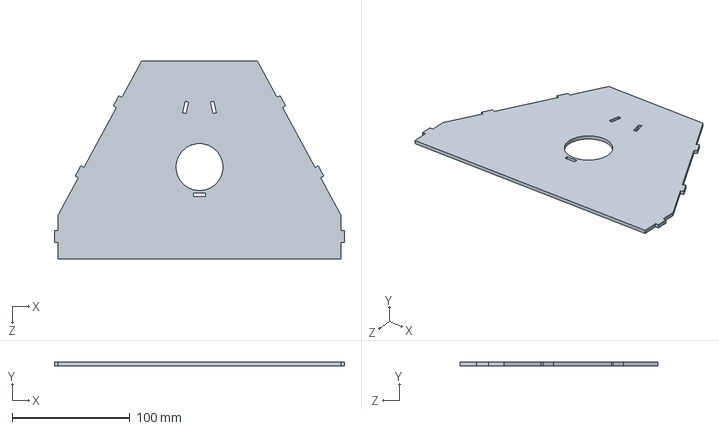
[picture p57: CAD file, 2024-12-19]
cad_models/iteration_1/fog_device_model/housing_lasercut_sheets/top_with_hole.SLDPRT
246.0 x 3.00 x 168.0 mm
