TheRARELab/fog-screen-robot-system/cad_models/first_prototype/3D_printing_models/airflow_former.STL

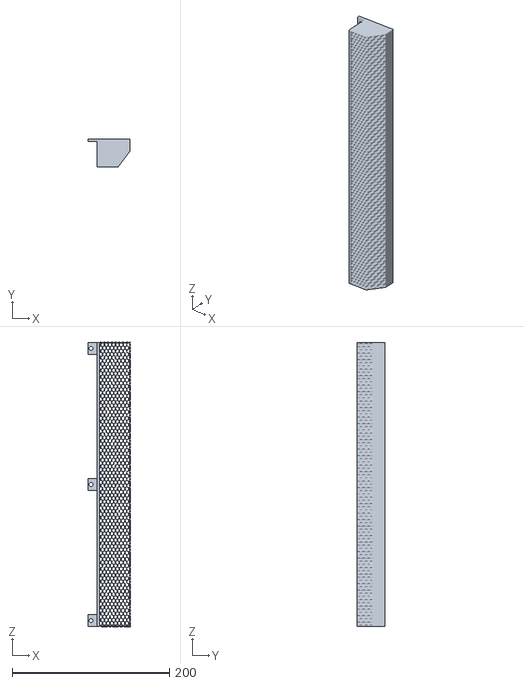
[picture p58: CAD file, 2024-12-19]
cad_models/first_prototype/3D_printing_models/airflow_former.STL
53.6 x 35.0 x 361.1
