TheRARELab/fog-screen-robot-system/cad_models/iteration_1/fog_device_model/fog_machine.SLDPRT

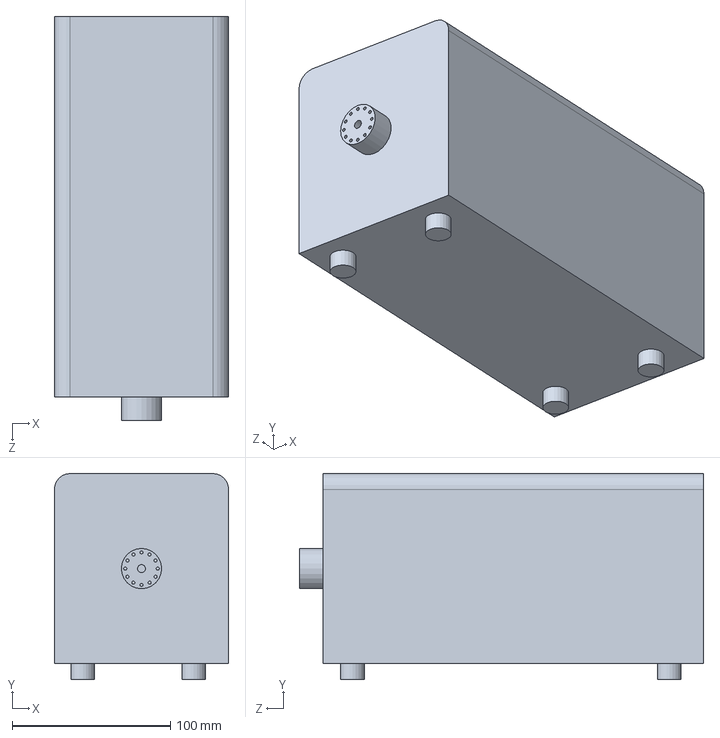
[picture p60: CAD file, 2024-12-19]
cad_models/iteration_1/fog_device_model/fog_machine.SLDPRT
110.0 x 130.0 x 255.0 mm
