TheRARELab/fog-screen-robot-system/cad_models/first_prototype/3D_printing_models/microfogger.SLDPRT

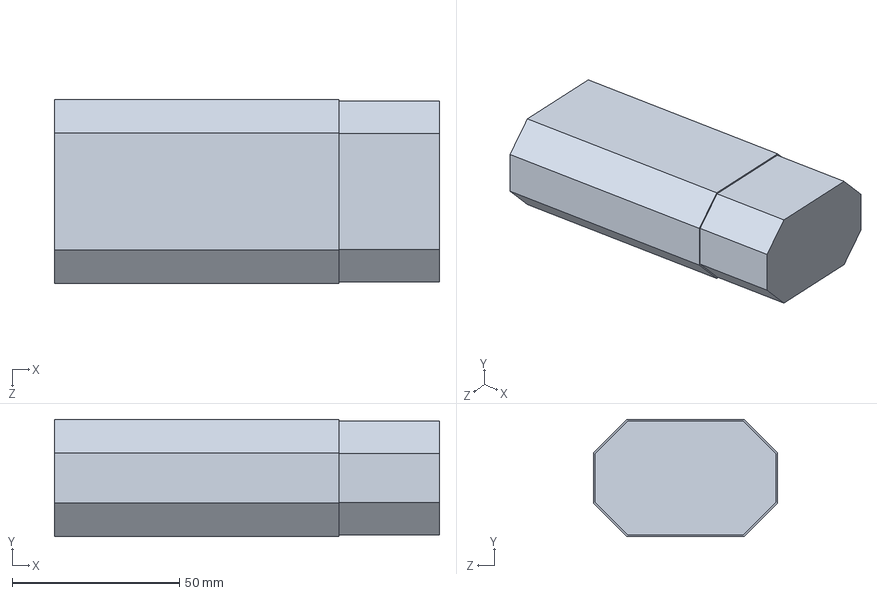
[picture p61: CAD file, 2024-12-19]
cad_models/first_prototype/3D_printing_models/microfogger.SLDPRT
115.0 x 35.0 x 55.0 mm
