TheRARELab/fog-screen-robot-system/cad_models/iteration_1/fog_device_model/5mm_housing_lasercut_sheets/5mm_test_half_airflow_former_iteration1.STL

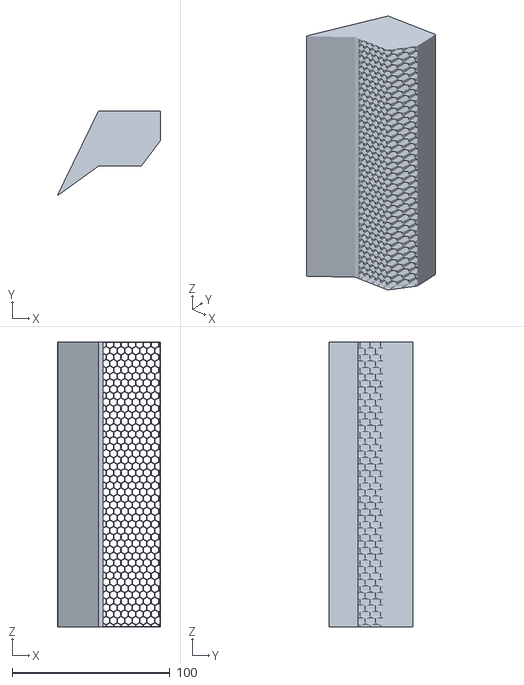
[picture p62: CAD file, 2024-12-19]
cad_models/iteration_1/fog_device_model/5mm_housing_lasercut_sheets/5mm_test_half_airflow_former_iteration1.STL
65.0 x 53.4 x 180.5
