TheRARELab/fog-screen-robot-system/(list of files, cad)

Other CAD files:
cad_models/first_prototype/3D_printing_models/improvement_testing/half_airflow_former2.STL
cad_models/first_prototype/laser_cutting_models/inner_cut_housing.SLDPRT
cad_models/first_prototype/3D_printing_models/baseline_housing.STL
cad_models/first_prototype/3D_printing_models/fan_slot.STL
cad_models/first_prototype/3D_printing_models/fog_container.STL
cad_models/first_prototype/3D_printing_models/improvement_testing/fog_outlet_reduce.STL
cad_models/first_prototype/3D_printing_models/microfogger.STL
cad_models/first_prototype/laser_cutting_models/fan_slot.DWG
cad_models/first_prototype/laser_cutting_models/fan_slot.STL
cad_models/first_prototype/laser_cutting_models/floor_container.DWG
cad_models/first_prototype/laser_cutting_models/floor_container.STL
cad_models/first_prototype/laser_cutting_models/front_container.DWG
cad_models/first_prototype/laser_cutting_models/front_container.STL
cad_models/first_prototype/laser_cutting_models/front_cut_housing.DWG
cad_models/first_prototype/laser_cutting_models/front_cut_housing.STL
cad_models/first_prototype/laser_cutting_models/inner_cut_housing.DWG
cad_models/first_prototype/laser_cutting_models/inner_cut_housing.STL
cad_models/first_prototype/laser_cutting_models/side_container.DWG
cad_models/first_prototype/laser_cutting_models/side_container.STL
cad_models/first_prototype/laser_cutting_models/side_cut_housing.DWG
cad_models/first_prototype/laser_cutting_models/side_cut_housing.STL
cad_models/iteration_1/fog_device_model/5mm_housing_lasercut_sheets/fan_side.STL
cad_models/iteration_1/fog_device_model/5mm_housing_lasercut_sheets/front.STL
cad_models/iteration_1/fog_device_model/5mm_housing_lasercut_sheets/housing_sliced_parts_assembly.STL
cad_models/iteration_1/fog_device_model/5mm_housing_lasercut_sheets/inner_floor.STL
cad_models/iteration_1/fog_device_model/5mm_housing_lasercut_sheets/inner_sheet.STL
cad_models/iteration_1/fog_device_model/5mm_housing_lasercut_sheets/top.STL
cad_models/iteration_1/fog_device_model/5mm_housing_lasercut_sheets/top_with_hole.STL
cad_models/iteration_1/fog_device_model/fan_120.STL
cad_models/iteration_1/fog_device_model/fog_machine.STL
cad_models/iteration_1/fog_device_model/housing_iteration1.STL
cad_models/iteration_1/fog_device_model/housing_lasercut_sheets/fan_side.STL
cad_models/iteration_1/fog_device_model/housing_lasercut_sheets/front.STL
cad_models/iteration_1/fog_device_model/housing_lasercut_sheets/housing_sliced_parts_assembly.STL
cad_models/iteration_1/fog_device_model/housing_lasercut_sheets/inner_floor.STL
cad_models/iteration_1/fog_device_model/housing_lasercut_sheets/inner_sheet.STL
cad_models/iteration_1/fog_device_model/housing_lasercut_sheets/top.STL
cad_models/iteration_1/fog_device_model/housing_lasercut_sheets/top_with_hole.STL
cad_models/iteration_1/fog_device_model/mount_structures/projector_raise.STL
cad_models/iteration_1/fog_device_model/pipe.STL
cad_models/iteration_1/fog_device_model/rotor_120.STL
cad_models/iteration_1/fog_device_model/stator_120.STL
cad_models/iteration_1/fog_machine_brackets/fog_machine_back_bracket.STL
cad_models/iteration_1/fog_machine_brackets/fog_machine_front_bracket.STL
cad_models/iteration_1/fog_machine_brackets/fog_machine_left_bracket.STL
cad_models/iteration_1/fog_machine_brackets/fog_machine_right_bracket.STL
cad_models/iteration_1/fog_screen_brackets/fog_screen_on_shelf_assembly.STL
cad_models/iteration_1/fog_screen_brackets/fog_screen_on_shelf_bracket_back.STL
cad_models/iteration_1/fog_screen_brackets/fog_screen_on_shelf_bracket_left.STL
cad_models/iteration_1/fog_screen_brackets/fog_screen_on_shelf_bracket_right.STL
cad_models/iteration_1/fog_screen_shelf/fog_screen_shelf.stl
cad_models/iteration_1/projector_shelf/bottom_leg_1.STL
cad_models/iteration_1/projector_shelf/bottom_leg_2.STL
cad_models/iteration_1/projector_shelf/bottom_leg_3.STL
cad_models/iteration_1/projector_shelf/bottom_leg_4.STL
cad_models/iteration_1/projector_shelf/projector_shelf_assembly.STL
cad_models/iteration_1/projector_shelf/projector_shelf_top_with_legs.STL
fog-machine-control/case/FogScreenControllerCase/Klein_FogScreenControllerCaseLidUpdate.STL
fog-machine-control/case/FogScreenControllerCase/Klein_FogScreenControllerCaseUpdate.STL
