TheRARELab/fog-screen-robot-system/case_studies_evaluation/image/light_bulb.jpg

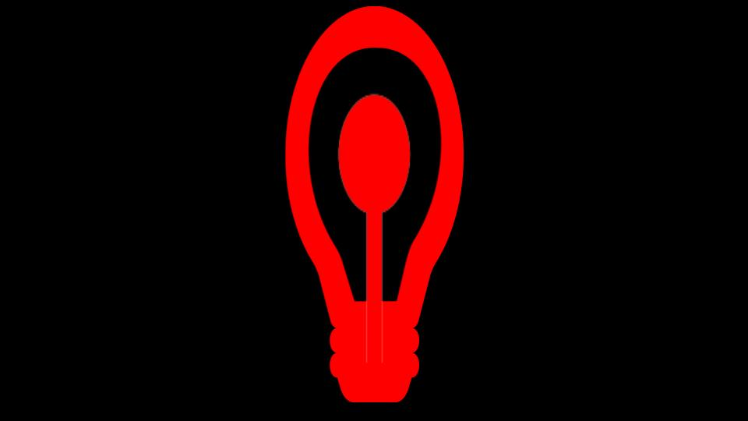
case_studies_evaluation/image/light_bulb.jpg
