TheRARELab/fog-screen-robot-system/case_studies_evaluation/image/wall_plug.jpg

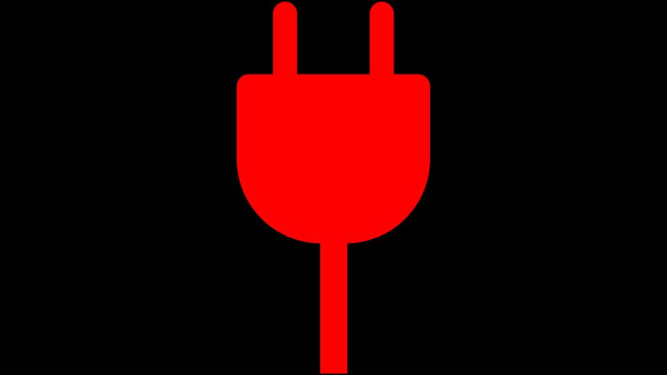
case_studies_evaluation/image/wall_plug.jpg
