TheRARELab/fog-screen-robot-system/(commit log)

2025-02-01 Add assemble doc & parts list (#1)
    [parts.csv]
2025-02-13 Added the case updated by Micheal
    [FogScreenControllerCase.stl, FogScreenControllerCaseLid.stl, Klein_FogScreenControllerCaseLidUpdate.SLDPRT, Klein_FogScreenControllerCaseLidUpdate.STL, Klein_FogScreenControllerCaseUpdate.SLDPRT, Klein_FogScreenControllerCaseUpdate.STL]
2025-02-13 Added PCB files from OSF
    [BOM_2024-11-13.csv, PickAndPlace_PCB_2024-11-13.csv]
2025-02-14 Added a README for the PCB Folder
2025-02-14 I completed the README for the PCbB
2025-02-14 Completed the README for the Arduino Sketch
